FlinkbaumFAU/IHP__TPU5555/TPU5555-main/verification/mdll-v2/metrics.csv

Metric | Value
design__instance__count | 118328
design__instance__area | 3.44331E+6
design__instance_unmapped__count | 0
synthesis__check_error__count | 0
design__max_slew_violation__count__corner:nom_fast_1p32V_m40C | 0
design__max_fanout_violation__count__corner:nom_fast_1p32V_m40C | 211
design__max_cap_violation__count__corner:nom_fast_1p32V_m40C | 0
power__internal__total | 0.0652141124010086
power__switching__total | 0.0029051564633846283
power__leakage__total | 0.00006359273538691923
power__total | 0.06818286329507828
clock__skew__worst_hold__corner:nom_fast_1p32V_m40C | -0.6087551746108862
clock__skew__worst_setup__corner:nom_fast_1p32V_m40C | 0.5518645141514027
timing__hold__ws__corner:nom_fast_1p32V_m40C | 0.10354778438890937
timing__setup__ws__corner:nom_fast_1p32V_m40C | 0.6629150194194666
timing__hold__tns__corner:nom_fast_1p32V_m40C | 0.0
timing__setup__tns__corner:nom_fast_1p32V_m40C | 0.0
timing__hold__wns__corner:nom_fast_1p32V_m40C | 0
timing__setup__wns__corner:nom_fast_1p32V_m40C | 0.0
timing__hold_vio__count__corner:nom_fast_1p32V_m40C | 0
timing__hold_r2r__ws__corner:nom_fast_1p32V_m40C | 0.103548
timing__hold_r2r_vio__count__corner:nom_fast_1p32V_m40C | 0
timing__setup_vio__count__corner:nom_fast_1p32V_m40C | 0
timing__setup_r2r__ws__corner:nom_fast_1p32V_m40C | 0.662915
timing__setup_r2r_vio__count__corner:nom_fast_1p32V_m40C | 0
design__max_slew_violation__count__corner:nom_slow_1p08V_125C | 0
design__max_fanout_violation__count__corner:nom_slow_1p08V_125C | 211
design__max_cap_violation__count__corner:nom_slow_1p08V_125C | 0
clock__skew__worst_hold__corner:nom_slow_1p08V_125C | -0.7774869856877815
clock__skew__worst_setup__corner:nom_slow_1p08V_125C | 0.669092689081256
timing__hold__ws__corner:nom_slow_1p08V_125C | 0.3152765915352819
timing__setup__ws__corner:nom_slow_1p08V_125C | 0.16900409328138524
timing__hold__tns__corner:nom_slow_1p08V_125C | 0.0
timing__setup__tns__corner:nom_slow_1p08V_125C | 0.0
timing__hold__wns__corner:nom_slow_1p08V_125C | 0
timing__setup__wns__corner:nom_slow_1p08V_125C | 0.0
timing__hold_vio__count__corner:nom_slow_1p08V_125C | 0
timing__hold_r2r__ws__corner:nom_slow_1p08V_125C | 0.315277
timing__hold_r2r_vio__count__corner:nom_slow_1p08V_125C | 0
timing__setup_vio__count__corner:nom_slow_1p08V_125C | 0
timing__setup_r2r__ws__corner:nom_slow_1p08V_125C | 0.169004
timing__setup_r2r_vio__count__corner:nom_slow_1p08V_125C | 0
design__max_slew_violation__count__corner:nom_typ_1p20V_25C | 0
design__max_fanout_violation__count__corner:nom_typ_1p20V_25C | 211
design__max_cap_violation__count__corner:nom_typ_1p20V_25C | 0
clock__skew__worst_hold__corner:nom_typ_1p20V_25C | -0.6674315733448323
clock__skew__worst_setup__corner:nom_typ_1p20V_25C | 0.5993510302148315
timing__hold__ws__corner:nom_typ_1p20V_25C | 0.18312628320968594
timing__setup__ws__corner:nom_typ_1p20V_25C | 0.4832755443728955
timing__hold__tns__corner:nom_typ_1p20V_25C | 0.0
timing__setup__tns__corner:nom_typ_1p20V_25C | 0.0
timing__hold__wns__corner:nom_typ_1p20V_25C | 0
timing__setup__wns__corner:nom_typ_1p20V_25C | 0.0
timing__hold_vio__count__corner:nom_typ_1p20V_25C | 0
timing__hold_r2r__ws__corner:nom_typ_1p20V_25C | 0.183126
timing__hold_r2r_vio__count__corner:nom_typ_1p20V_25C | 0
timing__setup_vio__count__corner:nom_typ_1p20V_25C | 0
timing__setup_r2r__ws__corner:nom_typ_1p20V_25C | 0.483276
timing__setup_r2r_vio__count__corner:nom_typ_1p20V_25C | 0
design__max_slew_violation__count | 0
design__max_fanout_violation__count | 211
design__max_cap_violation__count | 0
clock__skew__worst_hold | -0.6087551746108862
clock__skew__worst_setup | 0.5518645141514027
timing__hold__ws | 0.10354778438890937
timing__setup__ws | 0.16900409328138524
timing__hold__tns | 0.0
timing__setup__tns | 0.0
timing__hold__wns | 0
timing__setup__wns | 0.0
timing__hold_vio__count | 0
timing__hold_r2r__ws | 0.103548
timing__hold_r2r_vio__count | 0
timing__setup_vio__count | 0
timing__setup_r2r__ws | 0.169004
timing__setup_r2r_vio__count | 0
design__die__bbox | 0.0 0.0 2400.0 2000.0
design__core__bbox | 365.28 366.66 2034.72 1632.96
design__io | 29
design__die__area | 4.8E+6
design__core__area | 2.11401E+6
design__instance__count__stdcell | 32672
design__instance__area__stdcell | 500836
design__instance__count__macros | 7
design__instance__area__macros | 605725
design__instance__count__padcells | 192
design__instance__area__padcells | 1.2528E+6
design__instance__count__cover | 35
design__instance__area__cover | 171500
design__instance__utilization | 0.523442
design__instance__utilization__stdcell | 0.332056
design__rows | 609
design__rows:CoreSite | 609
design__sites | 778925
design__sites:CoreSite | 778925
design__instance__count__class:macro | 7
design__instance__area__class:macro | 605725
design__instance__count__class:input_pad | 12
design__instance__area__class:input_pad | 172800
design__instance__count__class:output_pad | 13
design__instance__area__class:output_pad | 187200
design__instance__count__class:power_pad | 10
design__instance__area__class:power_pad | 144000
design__instance__count__class:buffer | 33
design__instance__area__class:buffer | 529.805
design__instance__count__class:inverter | 451
design__instance__area__class:inverter | 2454.88
design__instance__count__class:sequential_cell | 3003
design__instance__area__class:sequential_cell | 147115
design__instance__count__class:multi_input_combinational_cell | 12375
design__instance__area__class:multi_input_combinational_cell | 127258
flow__warnings__count | 782
flow__errors__count | 0
flow__warnings__count:IFP-0028 | 1
flow__warnings__count:ODB-0220 | 1
flow__warnings__type_count | 1
flow__warnings__count:ORD-0039 | 1
design__instance__count__class:pad_spacer | 157
design__instance__area__class:pad_spacer | 748800
design__instance__count__class:cover | 35
design__instance__area__class:cover | 171500
flow__warnings__count:PAD-0033 | 4
design__power_grid_violation__count__net:VSS | 0
design__power_grid_violation__count__net:VDD | 0
design__power_grid_violation__count | 0
flow__warnings__count:GRT-0281 | 2
timing__drv__floating__nets | 0
timing__drv__floating__pins | 0
design__instance__displacement__total | 580.8
design__instance__displacement__mean | 0.017
design__instance__displacement__max | 13.8
route__wirelength__estimated | 1.07152E+6
design__violations | 0
design__instance__count__class:timing_repair_buffer | 16051
design__instance__area__class:timing_repair_buffer | 212463
flow__warnings__count:RSZ-0065 | 1
flow__warnings__count:STA-1140 | 2
design__instance__count__class:clock_buffer | 381
design__instance__area__class:clock_buffer | 8749.04
design__instance__count__class:clock_inverter | 168
design__instance__area__class:clock_inverter | 1123.11
flow__warnings__count:CTS-0041 | 57
flow__warnings__count:CTS-0128 | 1
flow__warnings__count:ODB-0047 | 1
design__instance__count__setup_buffer | 0
design__instance__count__hold_buffer | 0
flow__warnings__count:RSZ-0064 | 1
global_route__vias | 5
global_route__wirelength | 1582351
antenna__violating__nets | 0
antenna__violating__pins | 0
route__antenna_violation__count | 0
design__instance__count__class:antenna_cell | 210
design__instance__area__class:antenna_cell | 1143.07
flow__warnings__count:EST-0026 | 1001
antenna_diodes_count | 1
route__net | 32445
route__net__special | 29
route__drc_errors__iter:0 | 16
route__wirelength__iter:0 | 1117894
route__drc_errors__iter:1 | 0
route__wirelength__iter:1 | 1117898
route__drc_errors__iter:2 | 2285
route__wirelength__iter:2 | 1119014
route__drc_errors__iter:3 | 59
route__wirelength__iter:3 | 1118046
route__drc_errors__iter:4 | 5
route__wirelength__iter:4 | 1118042
route__drc_errors__iter:5 | 0
route__wirelength__iter:5 | 1118042
route__drc_errors | 0
route__wirelength | 1117898
route__vias | 168026
route__vias__singlecut | 168026
route__vias__multicut | 0
flow__warnings__count:DRT-0349 | 7
flow__warnings__count:DRT-0418 | 278
design__disconnected_pin__count | 0
design__critical_disconnected_pin__count | 0
route__wirelength__max | 1945.7
design__instance__count__class:fill_cell | 85422
design__instance__area__class:fill_cell | 912445
timing__unannotated_net__count__corner:nom_fast_1p32V_m40C | 239
timing__unannotated_net_filtered__count__corner:nom_fast_1p32V_m40C | 0
timing__unannotated_net__count__corner:nom_slow_1p08V_125C | 239
timing__unannotated_net_filtered__count__corner:nom_slow_1p08V_125C | 0
timing__unannotated_net__count__corner:nom_typ_1p20V_25C | 239
timing__unannotated_net_filtered__count__corner:nom_typ_1p20V_25C | 0
timing__unannotated_net__count | 239
timing__unannotated_net_filtered__count | 0
design_powergrid__voltage__worst__net:VDD__corner:nom_typ_1p20V_25C | 1.14764
design_powergrid__drop__average__net:VDD__corner:nom_typ_1p20V_25C | 1.18847
design_powergrid__drop__worst__net:VDD__corner:nom_typ_1p20V_25C | 0.0523625
design_powergrid__voltage__worst__net:VSS__corner:nom_typ_1p20V_25C | 0.0439346
design_powergrid__drop__average__net:VSS__corner:nom_typ_1p20V_25C | 0.0063036
design_powergrid__drop__worst__net:VSS__corner:nom_typ_1p20V_25C | 0.0439346
design_powergrid__voltage__worst | 0.0439346
design_powergrid__voltage__worst__net:VDD | 1.14764
design_powergrid__drop__worst | 0.0523625
design_powergrid__drop__worst__net:VDD | 0.0523625
design_powergrid__voltage__worst__net:VSS | 0.0439346
design_powergrid__drop__worst__net:VSS | 0.0439346
ir__voltage__worst | 1.149999999999999911182158029987476766109466552734375
ir__drop__avg | 0.0114999999999999998057109706905976054258644580841064453125
ir__drop__worst | 0.052400000000000002131628207280300557613372802734375
flow__warnings__count:ODB-0284 | 782
klayout__antenna_error__count | 0
klayout__density_error__count | 0
klayout__drc_error__count | 0
design__lvs_error__count | 0
