FlinkbaumFAU/IHP__TPU5555/TPU5555-main/verification/full-test-v7/metrics.csv

Metric | Value
design__instance__count | 125015
design__instance__area | 3.39201E+6
design__instance_unmapped__count | 0
synthesis__check_error__count | 0
design__max_slew_violation__count__corner:nom_fast_1p32V_m40C | 0
design__max_fanout_violation__count__corner:nom_fast_1p32V_m40C | 216
design__max_cap_violation__count__corner:nom_fast_1p32V_m40C | 0
power__internal__total | 0.0005616452544927597
power__switching__total | 0.0001675825915299356
power__leakage__total | 0.00006911168748047203
power__total | 0.0007983395480550826
clock__skew__worst_hold__corner:nom_fast_1p32V_m40C | -0.7430087866383323
clock__skew__worst_setup__corner:nom_fast_1p32V_m40C | 0.6682684594844635
timing__hold__ws__corner:nom_fast_1p32V_m40C | 0.18194563037854497
timing__setup__ws__corner:nom_fast_1p32V_m40C | 12.558171746843831
timing__hold__tns__corner:nom_fast_1p32V_m40C | 0.0
timing__setup__tns__corner:nom_fast_1p32V_m40C | 0.0
timing__hold__wns__corner:nom_fast_1p32V_m40C | 0
timing__setup__wns__corner:nom_fast_1p32V_m40C | 0.0
timing__hold_vio__count__corner:nom_fast_1p32V_m40C | 0
timing__hold_r2r__ws__corner:nom_fast_1p32V_m40C | 0.181946
timing__hold_r2r_vio__count__corner:nom_fast_1p32V_m40C | 0
timing__setup_vio__count__corner:nom_fast_1p32V_m40C | 0
timing__setup_r2r__ws__corner:nom_fast_1p32V_m40C | 12.575507
timing__setup_r2r_vio__count__corner:nom_fast_1p32V_m40C | 0
design__max_slew_violation__count__corner:nom_slow_1p08V_125C | 0
design__max_fanout_violation__count__corner:nom_slow_1p08V_125C | 216
design__max_cap_violation__count__corner:nom_slow_1p08V_125C | 0
clock__skew__worst_hold__corner:nom_slow_1p08V_125C | -0.9451116823332093
clock__skew__worst_setup__corner:nom_slow_1p08V_125C | 0.7744157756479012
timing__hold__ws__corner:nom_slow_1p08V_125C | 0.7846785665554852
timing__setup__ws__corner:nom_slow_1p08V_125C | 2.2992488563869857
timing__hold__tns__corner:nom_slow_1p08V_125C | 0.0
timing__setup__tns__corner:nom_slow_1p08V_125C | 0.0
timing__hold__wns__corner:nom_slow_1p08V_125C | 0
timing__setup__wns__corner:nom_slow_1p08V_125C | 0.0
timing__hold_vio__count__corner:nom_slow_1p08V_125C | 0
timing__hold_r2r__ws__corner:nom_slow_1p08V_125C | 0.784679
timing__hold_r2r_vio__count__corner:nom_slow_1p08V_125C | 0
timing__setup_vio__count__corner:nom_slow_1p08V_125C | 0
timing__setup_r2r__ws__corner:nom_slow_1p08V_125C | 2.299249
timing__setup_r2r_vio__count__corner:nom_slow_1p08V_125C | 0
design__max_slew_violation__count__corner:nom_typ_1p20V_25C | 0
design__max_fanout_violation__count__corner:nom_typ_1p20V_25C | 216
design__max_cap_violation__count__corner:nom_typ_1p20V_25C | 0
clock__skew__worst_hold__corner:nom_typ_1p20V_25C | -0.8140741644544547
clock__skew__worst_setup__corner:nom_typ_1p20V_25C | 0.7118230650838291
timing__hold__ws__corner:nom_typ_1p20V_25C | 0.39741649984640065
timing__setup__ws__corner:nom_typ_1p20V_25C | 8.789381915510027
timing__hold__tns__corner:nom_typ_1p20V_25C | 0.0
timing__setup__tns__corner:nom_typ_1p20V_25C | 0.0
timing__hold__wns__corner:nom_typ_1p20V_25C | 0
timing__setup__wns__corner:nom_typ_1p20V_25C | 0.0
timing__hold_vio__count__corner:nom_typ_1p20V_25C | 0
timing__hold_r2r__ws__corner:nom_typ_1p20V_25C | 0.397417
timing__hold_r2r_vio__count__corner:nom_typ_1p20V_25C | 0
timing__setup_vio__count__corner:nom_typ_1p20V_25C | 0
timing__setup_r2r__ws__corner:nom_typ_1p20V_25C | 8.789382
timing__setup_r2r_vio__count__corner:nom_typ_1p20V_25C | 0
design__max_slew_violation__count | 0
design__max_fanout_violation__count | 216
design__max_cap_violation__count | 0
clock__skew__worst_hold | -0.7430087866383323
clock__skew__worst_setup | 0.6682684594844635
timing__hold__ws | 0.18194563037854497
timing__setup__ws | 2.2992488563869857
timing__hold__tns | 0.0
timing__setup__tns | 0.0
timing__hold__wns | 0
timing__setup__wns | 0.0
timing__hold_vio__count | 0
timing__hold_r2r__ws | 0.181946
timing__hold_r2r_vio__count | 0
timing__setup_vio__count | 0
timing__setup_r2r__ws | 2.299249
timing__setup_r2r_vio__count | 0
design__die__bbox | 0.0 0.0 2400.0 2000.0
design__core__bbox | 365.28 366.66 2034.72 1632.96
design__io | 16
design__die__area | 4.8E+6
design__core__area | 2.11401E+6
design__instance__count__stdcell | 32620
design__instance__area__stdcell | 500390
design__instance__count__macros | 6
design__instance__area__macros | 529728
design__instance__count__padcells | 154
design__instance__area__padcells | 1.2528E+6
design__instance__count__cover | 22
design__instance__area__cover | 107800
design__instance__utilization | 0.487281
design__instance__utilization__stdcell | 0.315846
design__rows | 525
design__rows:CoreSite | 525
design__sites | 827645
design__sites:CoreSite | 827645
design__instance__count__class:macro | 6
design__instance__area__class:macro | 529728
design__instance__count__class:input_pad | 10
design__instance__area__class:input_pad | 144000
design__instance__count__class:output_pad | 2
design__instance__area__class:output_pad | 28800
design__instance__count__class:power_pad | 10
design__instance__area__class:power_pad | 144000
design__instance__count__class:buffer | 32
design__instance__area__class:buffer | 513.475
design__instance__count__class:inverter | 503
design__instance__area__class:inverter | 2737.93
design__instance__count__class:sequential_cell | 3001
design__instance__area__class:sequential_cell | 147015
design__instance__count__class:multi_input_combinational_cell | 12140
design__instance__area__class:multi_input_combinational_cell | 126723
flow__warnings__count | 782
flow__errors__count | 0
flow__warnings__count:IFP-0028 | 1
flow__warnings__count:ODB-0220 | 1
flow__warnings__type_count | 1
flow__warnings__count:ORD-0039 | 1
design__instance__count__class:pad_spacer | 132
design__instance__area__class:pad_spacer | 936000
design__instance__count__class:cover | 22
design__instance__area__class:cover | 107800
flow__warnings__count:PAD-0033 | 4
design__power_grid_violation__count__net:VSS | 0
design__power_grid_violation__count__net:VDD | 0
design__power_grid_violation__count | 0
flow__warnings__count:GRT-0281 | 2
timing__drv__floating__nets | 0
timing__drv__floating__pins | 0
design__instance__displacement__total | 72.96
design__instance__displacement__mean | 0.002
design__instance__displacement__max | 6.18
route__wirelength__estimated | 1.09161E+6
design__violations | 0
design__instance__count__class:timing_repair_buffer | 16191
design__instance__area__class:timing_repair_buffer | 212648
flow__warnings__count:RSZ-0065 | 1
design__instance__count__class:clock_buffer | 365
design__instance__area__class:clock_buffer | 8380.71
design__instance__count__class:clock_inverter | 176
design__instance__area__class:clock_inverter | 1217.46
flow__warnings__count:CTS-0041 | 57
flow__warnings__count:CTS-0128 | 1
design__instance__count__setup_buffer | 0
design__instance__count__hold_buffer | 10
global_route__vias | 15
global_route__wirelength | 1598428
antenna__violating__nets | 0
antenna__violating__pins | 0
route__antenna_violation__count | 0
design__instance__count__class:antenna_cell | 212
design__instance__area__class:antenna_cell | 1153.96
flow__warnings__count:EST-0026 | 1001
antenna_diodes_count | 3
route__net | 32386
route__net__special | 16
route__drc_errors__iter:0 | 21
route__wirelength__iter:0 | 1139353
route__drc_errors__iter:1 | 0
route__wirelength__iter:1 | 1139350
route__drc_errors__iter:2 | 2287
route__wirelength__iter:2 | 1140109
route__drc_errors__iter:3 | 63
route__wirelength__iter:3 | 1139373
route__drc_errors__iter:4 | 0
route__wirelength__iter:4 | 1139335
route__drc_errors | 0
route__wirelength | 1139350
route__vias | 168471
route__vias__singlecut | 168471
route__vias__multicut | 0
flow__warnings__count:DRT-0349 | 7
flow__warnings__count:DRT-0418 | 278
design__disconnected_pin__count | 0
design__critical_disconnected_pin__count | 0
route__wirelength__max | 1815.83
design__instance__count__class:fill_cell | 92213
design__instance__area__class:fill_cell | 1.00129E+6
timing__unannotated_net__count__corner:nom_fast_1p32V_m40C | 208
timing__unannotated_net_filtered__count__corner:nom_fast_1p32V_m40C | 0
timing__unannotated_net__count__corner:nom_slow_1p08V_125C | 208
timing__unannotated_net_filtered__count__corner:nom_slow_1p08V_125C | 0
timing__unannotated_net__count__corner:nom_typ_1p20V_25C | 208
timing__unannotated_net_filtered__count__corner:nom_typ_1p20V_25C | 0
timing__unannotated_net__count | 208
timing__unannotated_net_filtered__count | 0
design_powergrid__voltage__worst__net:VDD__corner:nom_typ_1p20V_25C | 1.19981
design_powergrid__drop__average__net:VDD__corner:nom_typ_1p20V_25C | 1.19985
design_powergrid__drop__worst__net:VDD__corner:nom_typ_1p20V_25C | 0.000188605
design_powergrid__voltage__worst__net:VSS__corner:nom_typ_1p20V_25C | 0.00016015
design_powergrid__drop__average__net:VSS__corner:nom_typ_1p20V_25C | 0.0000927719
design_powergrid__drop__worst__net:VSS__corner:nom_typ_1p20V_25C | 0.00016015
design_powergrid__voltage__worst | 0.00016015
design_powergrid__voltage__worst__net:VDD | 1.19981
design_powergrid__drop__worst | 0.000188605
design_powergrid__drop__worst__net:VDD | 0.000188605
design_powergrid__voltage__worst__net:VSS | 0.00016015
design_powergrid__drop__worst__net:VSS | 0.00016015
ir__voltage__worst | 1.1999999999999999555910790149937383830547332763671875
ir__drop__avg | 0.0001469999999999999952537965697274557896889746189117431640625
ir__drop__worst | 0.00018900000000000001325849152689073662259033881127834320068359375
flow__warnings__count:ODB-0284 | 782
klayout__antenna_error__count | 0
klayout__density_error__count | 0
klayout__drc_error__count | 0
design__lvs_error__count | 0
