FlinkbaumFAU/IHP__TPU5555/TPU5555-main/verification/drc/release/versions.txt

date: 2026-10-30T12:51:25+01:00
host: cae02
KLayout 0.30.7
PDK: 3f66c9137d520b3b5a3e39a2364afd6f9e2d7fee
20becef2be7c4c99030b0148a122ba040c8f9f3dc07b229dd406e45d6938165f  in/TPU5555.cdl
1613674470a091f20336fc72455b644e9f031fe6895789b8a6e14feff32cf6b0  in/TPU5555.gds
