FlinkbaumFAU/IHP__TPU5555/(commit log)

2026-10-26 TPU5555 v.1.0.0: HDC classifier chip with SPI interface (SG13CMOS5L)
    Release GDS with seal ring and fill (top cell renamed from hdc_chip_top to TPU5555,
    geometry identical to the signed-off LibreLane run full-test-v7), CDL and Verilog
    netlists, documentation, TRL assessment, RTL, flow scripts and verification logs.
    [TPU5555__nom_fast_1p32V_m40C.sdf, TPU5555__nom_slow_1p08V_125C.sdf, TPU5555__nom_typ_1p20V_25C.sdf, metrics.csv]
2026-10-30 Address review in issue #76: signoff on final release, precheck, license
    - Re-run DRC, precheck DRC (precheck_drc=true), density, antenna and LVS on
    the final TPU5555.gds/TPU5555.cdl: all 0 markers / netlists match. Logs,
    result databases and input hashes in TPU5555-main/verification/*/release/.
    - Release GDS: fix the sealring PCell area label (4.8e-06 -> 4.8 sq mm);
    geometry unchanged. Build and diff scripts in Flow/scripts/release/.
    - Compare all hard-IP cells against the PDK GDS (identical; 1024x32 SRAM
    geometrically identical with merged sub-cell names).
    - info.json: sealring_x/y in um (2400.0/2000.0).
    - Add LICENSE (Apache-2.0) and NOTICE.
    - Docs: remove the unsupported precheck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
    [metrics.csv]
2026-10-31 Add post-layout simulation of the routed netlist (TRL 5)
    Verilator simulation of the routed TPU5555 netlist through its SPI pads,
    using the HDC developer's SPI testbench, against the RTL as reference. On
    the full EMG data set (4347 training / 1088 test samples) and three random
    power-up states, the SPI protocol trace and all 1088 predictions are
    identical to RTL (1039/1088 correct).
    functional_stdcells.py/build.sh work around PDK models that only function
    with timing checks (delayed_* wires, SRAM FUNCTIONAL view) and model the
    dfrbpq flop with nonblocking semantics and start-up reset. The EMG
    recordings are not published (data/TestData is ignored).
    TRL checklist and info.json updated to TR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
    [chip_wrapper.v, functional_stdcells.py, tb_hdc_word40_gate.v]
2026-11-05 Add the MDLL sources (mixed_signal_design_blocks 9b729dc, custom_stdcell 33fd5af)
    TPU5555-main/mdll/: plain copies (git archive) of the all-digital MDLL's
    design repository and of its custom capacitor cells, kept as siblings so
    the MDLL flow finds custom_stdcell. The hard macro in v.2.0.0 was built
    from a6808fa; the commits up to 9b729dc change no layout input.
    README.md: what the MDLL is, how to rebuild and package the macro.
    [bbpd.sch, clk_gen.sch, dco.sch, delay_cell.sch, divider.sch, edge_lock_dector.sch, fast_osci.sch, mdll.sch]
2026-11-05 Flow and RTL: the MDLL as a hard macro with its own pads (hdc mdll-v2)
    The hdc repository's changes from 13a3f56 (the v.1.0.0 source) to f442cc4
    (run mdll-v2), with this repository's path remaps in config.yaml kept:
    - rtl/asic/hdc_chip_top.vhdl: i_mdll; pads for its clk_ref and resetb
    (IOPadIn), code[7:0] and locked (IOPadOut4mA), clk_out/4 (IOPadOut16mA)
    and clk_out itself (IOPadOut30mA).
    - constraints/sdc/chip_top.sdc: clocks mdll_ref (10 ns) and mdll_out
    (1.25 ns), asynchronous to the rest; hold uncertainty 0.05 ns on
    mdll_out; MDLL reset and outputs false-pathed.
    - config.yaml: pad order (MDLL pads at the top-right; spare3/4 south;
    LED pad bottom of the east side), the MDLL ma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
    [config.yaml, hdc_chip_top.vhdl]
2026-11-05 Implementation views of hdc run mdll-v2, renamed to TPU5555
    PlaceAndRoute/ (GDS, DEF, powered netlist, SPEF, LIB/SDF per corner) and
    synthesis/netlist/TPU5555.nl.v now come from mdll-v2, the chip with the
    MDLL (v.1.0.0's full-test-v7 views stay in the history and in
    release/v.1.0.0/).
    Flow/scripts/release/rename_views.py does the rename as it was done for
    v.1.0.0 (whose views are exactly full-test-v7's with hdc_chip_top
    replaced by TPU5555), and checks the number of occurrences per file. The
    GDS is make_release.py's output (top cell renamed, sealring label fixed),
    identical to release/v.2.0.0/gds/TPU5555.gds.
    [TPU5555__nom_fast_1p32V_m40C.sdf, TPU5555__nom_slow_1p08V_125C.sdf, TPU5555__nom_typ_1p20V_25C.sdf]
2026-11-05 Release v.2.0.0 files and their signoff checks
    release/v.2.0.0/: the GDS built by make_release.py from mdll-v2's final GDS
    (check_release.py: only the sealring label text differs), the renamed CDL
    and Verilog netlists, the CDLs they reference (plus the MDLL's pin-only
    mdll_bb.cdl and its complete mdll_full.cdl), flow metrics and render.
    Signoff re-run on the release files (cae02, KLayout 0.30.7, PDK 3f66c91,
    decks of hdc f442cc4), verification/{drc,lvs}/release_v.2.0.0/:
    DRC 0 (328 categories), precheck DRC 0 (259), density 0, antenna 0, LVS
    match. hard_ip_vs_pdk.txt: all 15 IO cell types and the SRAMs identical
    to the PDK (1024x32 geometrically, as in v.1.0.0); the mdll cell
    geometrically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
    [metrics.csv]
2026-11-05 Post-layout simulation of the v.2.0.0 netlist: identical to RTL
    chip_wrapper.v: the new MDLL pads (inputs tied low, outputs open) and a
    stub for the mdll macro, which has no digital model (verified at
    transistor level instead). Testbench, build script and cell-model
    generator are unchanged.
    Full EMG data set (4347 training / 1088 test samples), three power-up
    seeds: protocol trace and all 1088 predictions identical to RTL in every
    run, 1039/1088 correct; the RTL predictions are identical to v.1.0.0's.
    Results in results/v.2.0.0/ (build_env.txt has the hashes of the netlist,
    wrapper and testbench simulated); README updated.
    [chip_wrapper.v]
